sinara-hw/HV_AMP_8CH/README.md

# HV_AMP_8CH
8 channel +/- 200V 1MHz amplifier for Fastino

## Design Files

Design files (schematics, PCB layouts, BOMs) can be found at [HV_AMP_8CH/Releases](https://github.com/sinara-hw/HV_AMP_8CH/releases).

## Wiki

More information can be found on the [wiki](https://github.com/sinara-hw/HV_AMP_8CH/wiki).
