sinara-hw/HV_AMP_8CH/(list of files, drawings)

Other design files:
HV_Amp_Discrete.SchDoc
HVAMP_8CH.PrjPCB
HVAMP_8CH.SchDoc
LVDS_IFC_HVAMP.SchDoc
mechanics.SchDoc
Panel/Panel_HVAMP_8CH.PcbDoc
power_supplies_HVAMP.SchDoc
