sinara-hw/HV_AMP_8CH/(threads)

Thread 1 (2020-12-02):

initial spec

gkasprow, 2020-12-02:
We need this amplifier for AEGIS Ion trap control.
At lest 32 channels are needed so we will use Fastino and add 4 amplifier cards on its right side connected using flat cables.
additional EEMs will be used to directly control the opto-MOS relays on the amplifier outputs
I plan to use slighty modified discrete amplifiers used in Stabilizer Piezo Driver design. After replacing FETs with ones that work up to 450V I should be able to work in +/-200V range

gkasprow, 2020-12-02:
initial components placement
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

jordens, 2020-12-09:
Nice. A lot of the macroscopic trap people will like that. Is there a noise/bandwidth spec already?

gkasprow, 2020-12-16:
they say "the lower the better" :D

gkasprow, 2020-12-20:
Routing is done
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

dtcallcock, 2020-12-21:
What's the tempco likely to be?  Would be good if this amp doesn't significantly degrade Fastino in this regard.  Will the R10/R17 divider be the limit?

gkasprow, 2021-05-10:
I used 10ppm resistors so they seems to be the limit

Thread 2 (2021-01-14):

debugging

gkasprow, 2021-01-14:
The boards arrived
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

jordens, 2021-01-15:
Very nice!

gkasprow, 2021-01-15:
The HV discharge circuit causes HV converter overload during startup -> we have a 1.3A startup current which decays to 0.3A after a few seconds.
The circuit works properly and quickly discharges capacitors, but the 1k resistors are sparking, which means they must be replaced with HV version

gkasprow, 2021-01-15:
R81 is too high - it does not let enough current to flow to T10 emitter. It requires at least 0.6mA
Removal of R84 solves the issue.

gkasprow, 2021-01-15:
I suggest adding the 8V2 Zener diode in series with R81

gkasprow, 2021-01-15:
- [ ] R84 -> 47k
- [ ] R81 -> D8V2 + 3k3
- [ ] R75,R83 -> 10k+10k 1206. Existing 1K get damaged during discharge. After replacement by 1+1k they get damaged, too

gkasprow, 2021-01-15:
After the changes below, the HV disappears within 3s after 12V is disconnected so it is acceptable.

gkasprow, 2021-01-15:
the HV supplies produce +/- 232V instead of ~+/-205V

gkasprow, 2021-01-15:
It works nicely at +/-12V, but when HV is enabled, the output FETs get hot and the viltage is limited to +/-60V - the amplifier is oscillating at 4...5MHz causing obvious current overload

mrdorababu, 2021-01-19:
HI....
High voltage dc-dc converter both sides are having the same ground. If we are using the same ground plane, these grounds may be shorted.

gkasprow, 2021-04-29:
The oscillations are caused by over-current protection.
The transistors were designed to limit the upper and lower rail current by lowering output MOSFET VGS  voltage. Let's assume the upper MOSFET current is exceeded. The BJT opens and tries to lower the upper MOSFET VGS, but the gate signal is propagated to the lower MOSFET gate causing it to increase the current. The lower side overcurrent  BJT starts conducting, trying to lower the lower side MOSFET voltage, which is then transferred to the upper side MOSFET, and the situation repeats.
The remedy is simple - disable the protection with BJTs. and just lower the protection Zener diode voltage.
Another situation is with the biased current of output MOSFETs. It increases with temperature. The MOSFET temperature coefficient is positive for low currents and negative for high currents. That's why in audio power amps such compensation is often not needed, unlike the case of BJTs.

NFET:
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

PFET:
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

gkasprow, 2021-04-29:
So we have to compensate the Vgg.
We have limited MOSFET data, at 100mA the Vgs changes by 0.5V between 25C and 100C. It gives roughly  0.5V/70C = 7.1mV/K. At lower currents, the coefficient will likely be higher.
We can use 4 Si diodes connected in series to get 8mV/K  and add such slope in series with the upper and lower FET biasing resistors. They are controlled by a constant current source driven by an opamp, so that should provide some temperature compensation.

gkasprow, 2021-04-30:
We also need to add TVS that protects other opamps in case one channel fails.
In case of failure, it can happen that too high voltage appears at the opamp output and can be distributed via supply network to other channels.

gkasprow, 2021-05-01:
The amplifiers work very nicely, but with a 1MHz sinewave, they consume more than 25mA of current (10W of power). Moreover, they are very fragile to supply ripples due to the AC connection between the gate and opamp output. The PSRR is close to 0dB or even negative. Multi-channel construction must have a dedicated LDOs for both rails. Another issue is that the HV power on ramp must be slow, otherwise, both FETs get enabled. It seems this architecture is not suitable for that application and we should substitute these discrete amps with more typical topology.

gkasprow, 2021-05-01:
the temperature compensation implemented as four silicon diodes in series (BAV199S) actively reduce the current while heating. So the amplifier is thermally overcompensated which gives negative temperature feedback.

gkasprow, 2021-05-02:
Even mV ripples at the output of the power supply LC filter get amplified to tens of V. The effect is interesting because at the startup the amplifier output is still DC. The small bias heats the FETs which have a positive temperature coefficient, causing the current to rise to increase the power drawn from the supply. The thermal compensation diodes are still cold. But once the HV supply-demand increases, the ripples get higher. Since the PSRR is poor, they are amplified and at the output, I observe tens of V at 200kHz, which is the switching frequency of the converter. This causes further heating of the output stage, increasing the ripples. After a few seconds their amplitude is over 100V and gets stabilized because the thermal compensation diode got heated and decreased the bias current.
The amplifier construction is interesting because:
-  it has over 2MHz bandwidth.
-  it works well from the stabilized linear power supply.
- when working at high frequency, it draws a lot of power due to the cross-conduction effect. The transfer characteristics of FETs are far from being linear, and when applying the sinewave, there are some voltage regions where the cross-conduction current is high. I observed nearly 30mA drawn from DC power at 1MHz without load. It's a lot.
- it could be a good solution for pulse applications that require high bandwidth and very low Iq. The amps must have a dedicated LDO with good PSRR.

gkasprow, 2021-05-02:
For this particular application, we will use standard APEX high-voltage amplifiers. To get +/-200V output, we have to increase the voltage to +/- 220V. We can use existing power converters (100V version) but we have to connect them in series.

Closed 2021-05-10.

Thread 3 (2021-04-30):

errata

gkasprow, 2021-04-30:
- [x] R84 -> 47k
- [x] R81 -> D8V2 + 3k3
- [x] R75,R83 -> 10k+10k 1206. Existing 1K get damaged during discharge. After replacement by 1+1k they get damaged, too
- [x] add TVS to the opamp supply rails
- [x] modify the overcurrent protection
- [x] add thermal compensation

Closed 2021-05-10.

Thread 4 (2021-06-05):

v1.1 arrived

gkasprow, 2021-06-05:
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

jordens, 2021-06-05:
Is that with apexes? Could you upload the release data and PDF for that? I'd like to follow this development!

gkasprow, 2021-06-05:
yep. Done https://github.com/sinara-hw/HV_AMP_8CH/releases/tag/v1.1

gkasprow, 2021-06-21:
Full power BW
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

at 50kHz it's able to output 260Vpp
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

at 100kHz it's able to output 124Vpp
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

at 250kHz - 42Vpp
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

at 500kHz - 26Vpp, limited by SR
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

at 1MHz - 13Vpp limited by SR
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

square wave at 33kHz. We can clearly see SR of 30V/us as in the datasheet. It means that the input amp didn't break the spec. We need input amp due to HV amp GPB.
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

gkasprow, 2021-06-21:
Thermal protection works. After heating the temp sensor the HV and 24V rails get disabled.

Thread 6 (2021-09-06):

Inrush current during power up

mkiepiela, 2021-09-06:
Due to large capacitance on P12V0_SW rail, a high inrush current flows when T3 current switch is being turning on.
It can be a problem especially when more than one HVAMP is supplied from a single power supply.
Some soft start circuit would be useful.

For already manufactured items (v1.1) we made modification of the current switch circuit. We used the gate-source capacitance of T3 to slow down the turning-on process. Thanks to that the R_ds of T3 is limiting the current charging capacitors on P12V0_SW rail during the starting up.

Original circuit:
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

Modified circuit:
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

The modification of PCB done:
- carrefully desoldering and picking up the 4th pin of T3 (gate),
- soldering the resistor between picked up gate pin and solder pad of R23.

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

We used the 2 MOhm resistors which makes the power up process much smoother but still keeps T3 in its safe operating area.

gkasprow, 2021-09-06:
Thanks! Make sure you use an ESD environment. MOSFET gates are very fragile and even finger touch can kill one. Just equalize potentials before touching the circuit.

Closed 2023-04-03.

Thread 7 (2021-11-29):

stability and noise performance

jordens, 2021-11-29:
@gkasprow Do you or the AEGIS people already have any data on the stability, the temperature coefficient and the noise?

gkasprow, 2021-11-29:
that's a good question to @kaolpr

kaolpr, 2021-11-29:
AFAIK not yet. At TS we did only basic tests and AEgIS team is currently solving some problems with their setup. Don't think they managed to do any test before that. However, if any information comes up I'll inform you.

andrewvh4, 2022-02-21:
Are there any updates on these noise and stability performance measurements?

gkasprow, 2022-02-21:
@andrewvh4 CERN discovered that the amplifier is unstable with a long cable. I did several measurements with a modified compensation loop.
Here are the results. The screenshots have self-explanatory file names. The first case was with added 2.4pF capacitor. The second case was with added 8pF capacitor.
https://www.dropbox.com/sh/22puqkn01m83u8a/AADVKAsE6MOcG1ZhXLNaRnrHa?dl=0

gkasprow, 2023-04-03:
finally, 100pF 1808 capacitor will be used.

Thread 8 (2022-03-15):

further CERN tests

gkasprow, 2022-03-15:
After CERN guys had performed some additional tests in their lab, they have now reworked their first full HV amp board at CERN. For this, an additional compensation capacitor (100 pF, on RS: https://fr.rs-online.com/web/p/condensateurs-ceramique-multicouches/0133933) has been soldered onto the board for each channel (see attached images).

With that, they obtained very promising results so far. They have also attached an example oscilloscope image with three channels going to 5V simultaneously (no oscillations, quick ramp, no overshoot, stable signal) after an incoming trigger as well as example spectra analyzing the noise in different frequency ranges.
This seems to solve a lot of the problems they've encountered so far - they are still also analyzing the linearity, offsets, temperature dependence, ... but from what they see so far, also this has improved, and they are very optimistic.

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

Thread 10 (2022-07-13):

Low power PA97 variant

jordens, 2022-07-13:
For low slew rates and low quiescent power applications one could make a variant for the PA97. It's almost pin compatible and doesn't need cooling.

gkasprow, 2022-07-26:
good idea.
Btw, is not really related, but I made a list of Apex HV amplifiers.
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
[Apex_amps.xlsx](https://github.com/sinara-hw/HV_AMP_8CH/files/9191099/Apex_amps.xlsx)

jordens, 2023-04-25:
@gkasprow could you make a variant of v1.2 for PA97?

gkasprow, 2023-04-25:
It looks the PA97 can be installed without any modifications. Output is pin8 instead of 7, but we have their 3R6 resistor anyway, which won't make any difference because it's inside the feedback loop.

jordens, 2023-04-25:
What about BOM changes (no heatsink etc.)?

gkasprow, 2023-04-25:
sure, this need to be done but does not block the PCB review.

kaolpr, 2023-05-11:
> It looks the PA97 can be installed without any modifications. Output is pin8 instead of 7, but we have their 3R6 resistor anyway, which won't make any difference because it's inside the feedback loop.

It's not true. PA97 has two package styles: PC and DR (DR is NRND) whereas in HVAMP there is PA95 in DQ package used.
Those packages are not pin compatible.

jordens, 2023-05-11:
I don't see the problem.

kaolpr, 2023-05-11:
My mistake. It's fine. Although, we could make an assembly variant anyway.

gkasprow, 2023-05-11:
I will once I get CERN symbols

jordens, 2025-01-15:
Works fine. Closing.

Closed 2025-01-15.

Thread 9 (2022-07-13):

Output opto-switch open during power-up

mkiepiela, 2022-07-13:
Output opto-switch is open during power-up.

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

It is driven from LVDS receiver, which is in fail-safe condition (output HIGH) until FPGA boots and controls the LVDS lines.

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

gkasprow, 2022-07-22:
Is it a real issue? The expectation is that outputs are disconnected until the system boots up

gkasprow, 2022-07-28:
we would need to replace the receivers with a version that works from 0 differential voltage like MAX9113 or ADN4664

gkasprow, 2022-07-28:
in the next prototype, we will simply invert inputs and connect the optocoupler between OUT and P3V3

jordens, 2022-07-28:
Good. We've used that failsafe state for LVDS before (e.g. Sampler).

gkasprow, 2023-04-03:
I swapped LVDS inputs and the way the optomos is controlled (to VCC)

Closed 2023-04-03.

Thread 11 (2022-10-23):

output transients during power down

gkasprow, 2022-10-23:
The HV switches are kept on during power down, causing unwanted transients.
I tested quite an invasive solution that detects the P12V0 level and disables the LVDS receivers supply when the P12V0 rail falls below 11V.
I tested it on v1.0 HW, which has an identical opto-MOS switching circuit.
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

The result:
yellow trace - P12V0 rail
blue trace - the Opto-MOS control line
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

Schematic needs update. Red-dotted frame indicates added components.
I used [AP2311AS-13](https://www.mouser.pl/ProductDetail/Diodes-Incorporated/AP2311AS-13?qs=AsTZqt%2Fmeqn%2FDW%252BUUzUtIw%3D%3D) high-side switch together with two resistors and Zener diodes working as level detection circuit. The AP2133 needs 2V as a high input state, so two 4V7 Zener diodes give a 9.4+2=11.4V threshold when turning on. It needs 0.8V as a low input state, so 9.4+0.8 =10.2 is the threshold value when turning the power down.
Zener diodes need a few mA of current to maintain the correct voltage. I also added 220R resistor as a protection against input transients that could kill the high-side switch. It increases the thresholds by 0.45V.
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

One needs to cut two traces at the output of the P3V3 rail and add the circuit as on the schematic

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

gkasprow, 2023-04-03:
fixed in 1.2

Closed 2023-04-03.

Thread 12 (2023-04-03):

v1.2 changelog

gkasprow, 2023-04-03:
- swapped inputs of all LVDS receivers and optocouplers supplied with 3V3 instead of GND #9
- changed the name of OUT_CTRL to OUT_CTRLn; OUT_EN to OUT_ENn

kaolpr, 2023-05-11:
Please correct version on PCB.

Thread 13 (2024-07-10):

DIOT version

gkasprow, 2024-07-10:
We are moving all boards to the DIOT form factor.
The one idea is to merge eight channels of Fastino and HVAMP8 into an 8-channel high voltage DAC unit.
Another idea is to use new Fastino-DIOT SAS outputs and short SAS cables and implement SAS input on HV_AMP_8. Less elegant and will occupy one slot more in the chassis

Thread 14 (2024-08-29):

dip switches for enable override

jordens, 2024-08-29:
Having to hook up a coredevice just to enable channels is costly.
Can't we add a local DIP switch array to hard-enable channels in case there is no EEM connection?
Default off, logical OR with the enable signal from EEM.

gkasprow, 2024-08-30:
sure, let's do that.
This particular application required switching of outputs in programmable manner

Thread 15 (2024-09-26):

warn about short circuit

jordens, 2024-09-26:
Its certainly clear to anyone looking at the datasheets of the opto-mos and HV opamp that a short circuit will kill them. But let's put a warning on the front panel that the outputs are not short circuit proof (in the PA97 variant at least). Additionally, in the low-power variant with the PA97, I'd like to increase the series resistor R66 from 10R to a high value that protects the amp (maybe 1mA 0.2W 200k?) and potentially put it into the feedback loop as a current limit to keep the speed up. The PA97 officially doesn't have a ILIM input but looking at the circuit of PA97 vs PA95 it looks like the PA97 just misses the bipolar output stage and the PA97 output is in fact the ILIM input of the PA95. Maybe something can be done there.

jordens, 2024-10-08:
[Application Note 1 “General Operating Considerations”](https://www.apexanalog.com/resources/appnotes/an01u.pdf)

> Any attempt to limit current with a circuit external to the amplifier must be approached with extreme caution. The pitfalls are generally time related and are often catastrophic.

etc

jordens, 2024-10-08:
https://www.apexanalog.com/resources/appnotes/an53.pdf
The figure 6 circuit with a BSS126 might work. Could also be done as a separate in-line SMC-SMC "amp-saver".
